nayenay/MINAC/(commit log)

2025-09-10 :card_file_box: Conectar a base de datos
2025-09-12 Back para mongo db en type
    equipos
2025-09-12 codificacion de endpoints, y adapracion a realtime database
2025-09-12 🚧 Añadir equipo
2026-08-01 MVP para innovafest
2026-08-01 fix sensor reading object
2026-08-01 Update sensor calibration details in manual
    Added calibration details for MQ-3, MQ-9, and MQ-3 sensors, including burn-in times and specific gas curves for each sensor.
2026-08-03 calibracion y lógica final del circuito
2026-08-09 feat(frontend): add historical sensor charts
2026-09-15 Agregar landing page corporativa de MINAC (apps/landing)
    Nueva app Next.js independiente con identidad de marca clara/corporativa:
    logo real, acento mostaza exacto extraido del logo, secciones de problema,
    solucion, estado actual, equipo y formulario de contacto.
2026-09-15 :rocket: Landing ready
2026-09-27 Add laboratorio app: Web Serial ESP32 lab tool (burn-in, calibración, práctica)
    Unified Next.js interface for MINAC lab sensor work that reads the ESP32
    directly over USB from the browser (Web Serial API, no Python bridge) and
    writes exclusively to the laboratorio/ branch of Firebase, keeping
    monitoreo/ and historico/ untouched. Includes a WiFi-only Burn-in 24h
    dashboard backed by a client-side Firebase listener.
